drone-works/Shimonso-IoT-Type-R/Shimonso-IoT-Type-R.pdf

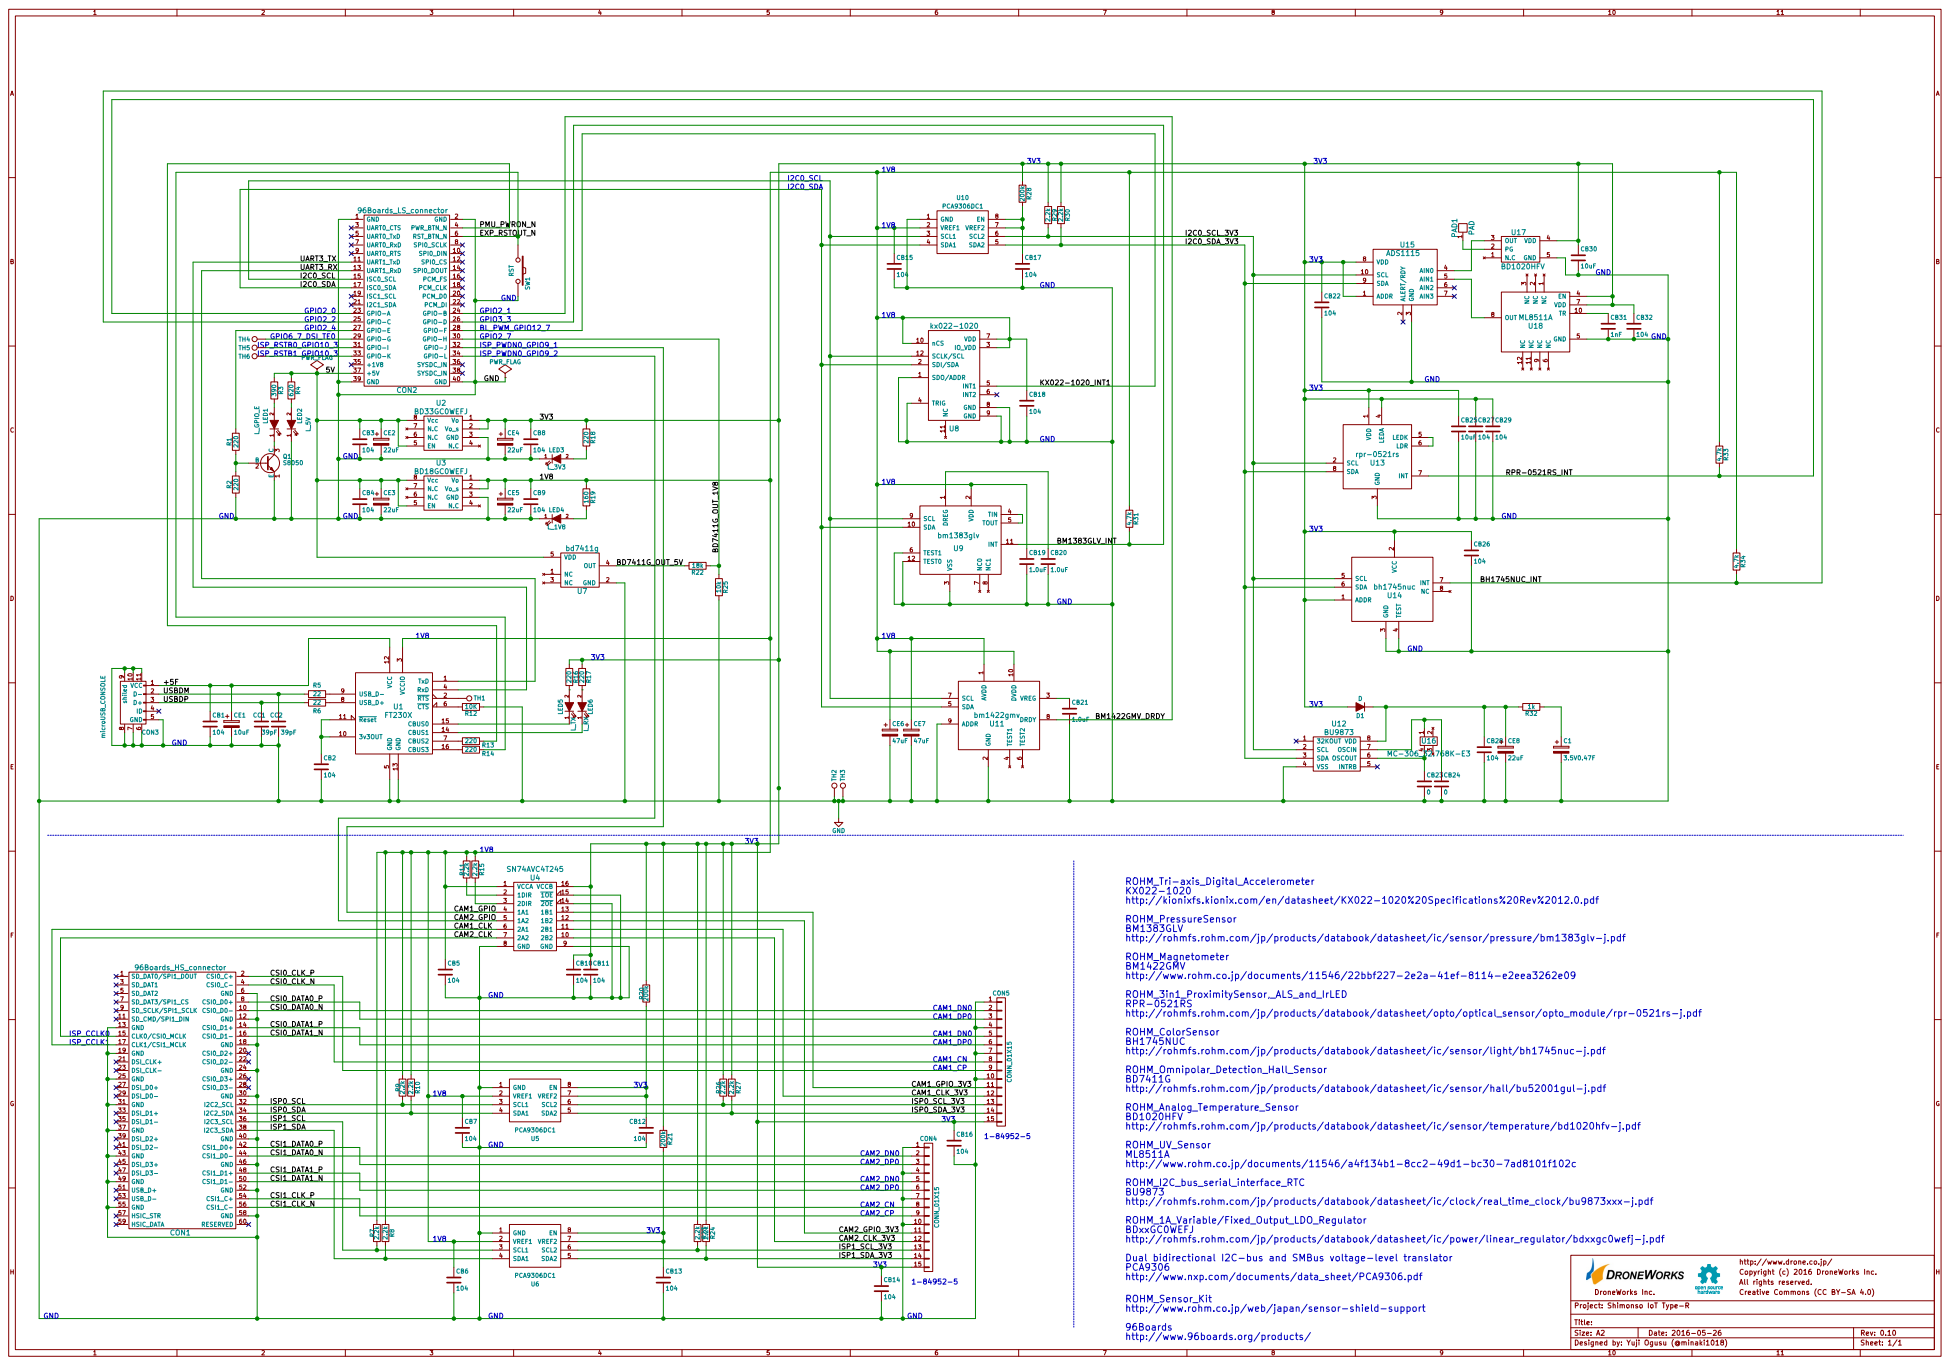
[picture p1: page 1]

I2C0_SCL
I2C0_SDA

LEDK LDR

GND

6 SCL 7 DRDY 8 ADDR 9 DVDD 10 U11

ROHM_Tri-axis_Digital_Accelerometer
http://kionixfs.kionix.com/en/datasheet/KX022-1020%20Specifications%20Rev%2012.0.pdf
ROHM_PressureSensor
BM1383GLV
http://rohmfs.rohm.com/jp/products/databook/datasheet/ic/sensor/pressure/bm1383glv-j.pdf
ROHM_Magnetometer
BM1422GMV
http://www.rohm.co.jp/documents/11546/22bbf227-2e2a-41ef-8114-e2eea3262e09
ROHM_3in1_ProximitySensor,_ALS_and_IrLED
RPR-0521RS
http://rohmfs.rohm.com/jp/products/databook/datasheet/opto/optical_sensor/opto_module/rpr-0521rs-j.pdf
ROHM_ColorSensor
BH1745NUC
http://rohmfs.rohm.com/jp/products/databook/datasheet/ic/sensor/light/bh1745nuc-j.pdf
ROHM_Omnipolar_Detection_Hall_Sensor
http://rohmfs.rohm.com/jp/products/databook/datasheet/ic/sensor/hall/bu52001gul-j.pdf
ROHM_Analog_Temperature_Sensor

CSI0_DATA1_P | CAM1_DP0 | 3

CAM1_DN0 | 4

CAM1_DP0 | 6
CAM1_CN | 7

1V8 | CAM1_GPIO_3V3 | 10

CAM1_CP | 9

ISP0_SCL_3V3 | 13

ISP0_SDA | ISP0_SDA_3V3 | 14
ISP1_SCL
ISP1_SDA
CSI1_CLK_P | CAM2_DP0 | 15CON4 CONN_01X15 CB14 6

104 104 CB6 | CB12 | CAM2_DN0 | 4

BD1020HFV
http://rohmfs.rohm.com/jp/products/databook/datasheet/ic/sensor/temperature/bd1020hfv-j.pdf
ROHM_UV_Sensor
http://www.rohm.co.jp/documents/11546/a4f134b1-8cc2-49d1-bc30-7ad8101f102c
ROHM_I2C_bus_serial_interface_RTC
http://rohmfs.rohm.com/jp/products/databook/datasheet/ic/clock/real_time_clock/bu9873xxx-j.pdf
ROHM_1A_Variable/Fixed_Output_LDO_Regulator
BDxxGC0WEFJ
http://rohmfs.rohm.com/jp/products/databook/datasheet/ic/power/linear_regulator/bdxxgc0wefj-j.pdf
Dual bidirectional I2C-bus and SMBus voltage-level translator
PCA9306

http://www.nxp.com/documents/data_sheet/PCA9306.pdf 1-84952-5

CSI1_DATA1_P | | | CAM2_DP0 | 3

CAM2_CN | 7

CAM2_CP | 9

1V8 | CAM2_GPIO_3V3 | 10

All rights reserved.
Creative Commons (CC BY-SA 4.0)

ROHM_Sensor_Kit
http://www.rohm.co.jp/web/japan/sensor-shield-support
96Boards
http://www.96boards.org/products/

Project: Shimonso IoT Type-R

Designed by: Yuji Ogusu (@minaki1018)
