drone-works/Shimonso-IoT-Type-R/Shimonso-IoT-Type-R.kicad_pcb

## KiCad design Shimonso-IoT-Type-R.kicad_pcb (2016-08-15)

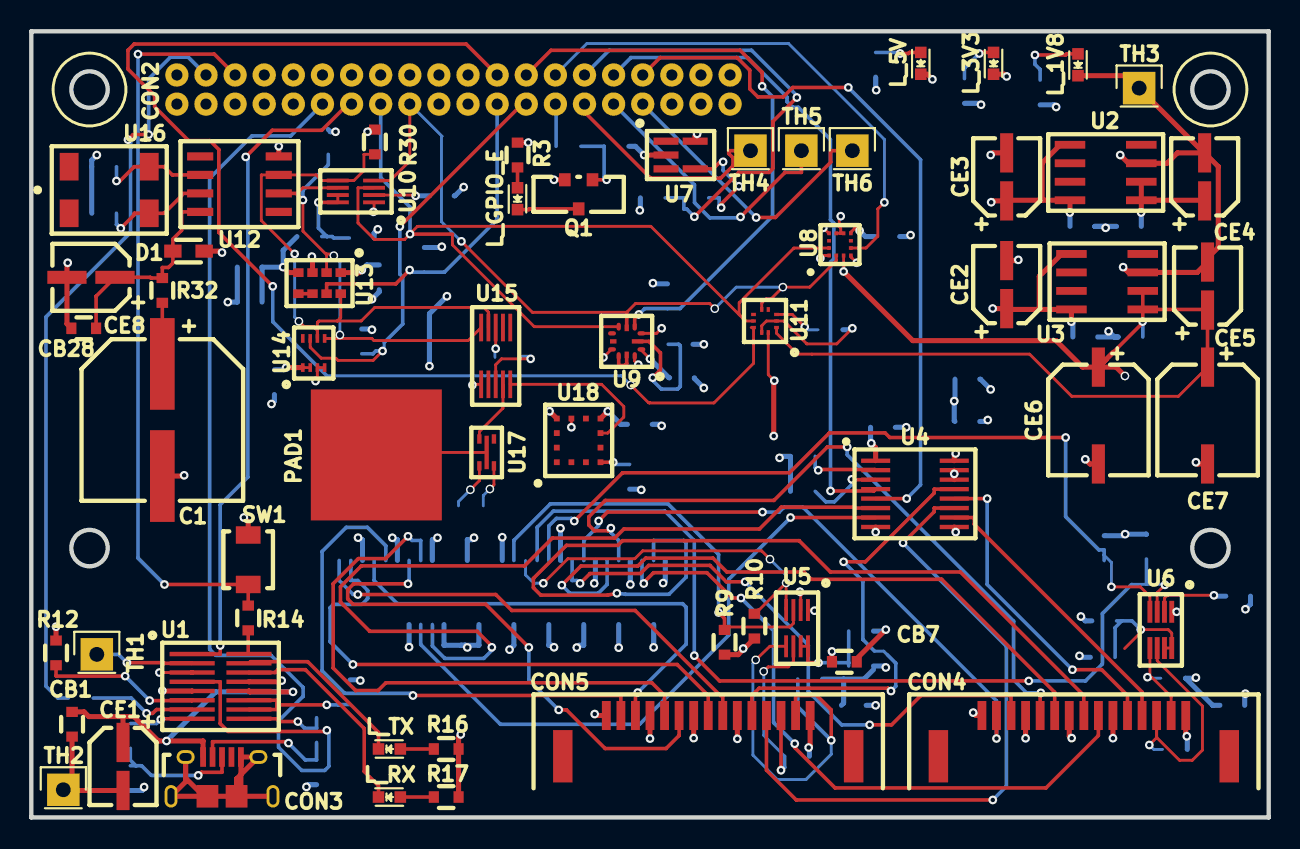
[picture p2: board Shimonso-IoT-Type-R.kicad_pcb from above]

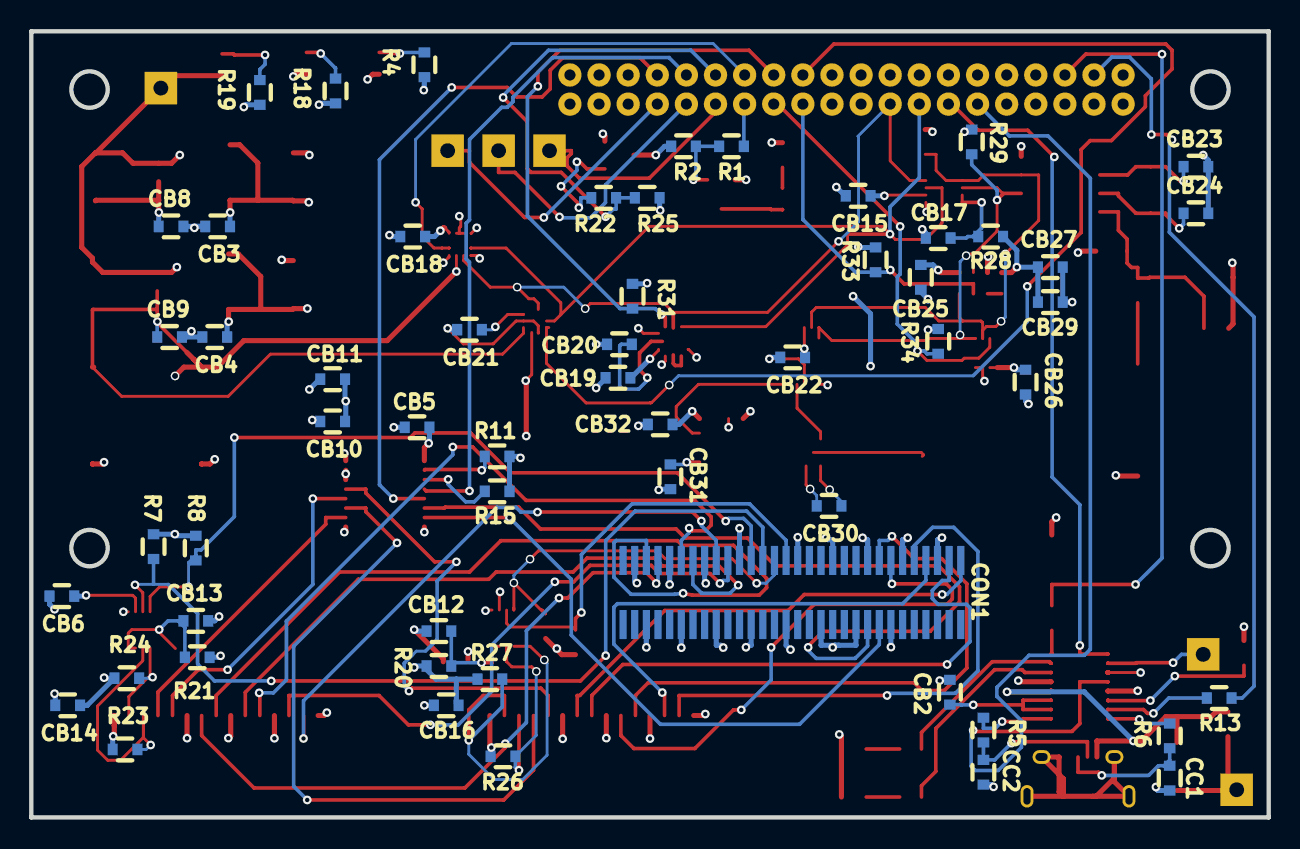
[picture p3: board Shimonso-IoT-Type-R.kicad_pcb from below]

Board: 4 copper layers, 85.0 x 54.0 mm, 116 parts (57 on the bottom side), 88 nets.

Parts:
C1: 3.5V0.47F; FCS0V474ZFTBR24
CB1, CB2, CB3, CB4, CB5, CB6, CB7, CB8, CB9, CB10, CB11, CB12, CB13, CB14, CB15, CB16, CB17, CB18, CB22, CB26, CB27, CB28, CB29, CB32: 104; GRM18
CB19, CB20, CB21: 1.0uF; GRM18
CB23, CB24: 0; GRM18
CB25, CB30: 10uF; GRM18
CB31: 1nF; GRM18
CC1, CC2: 39pF; GRM18
CE1: 10uF; OS-CON-A5
CE2, CE3, CE4, CE5, CE8: 22uF; OS-CON-A5
CE6, CE7: 47uF; OS-CON-C6
CON1: 96Boards_HS_connector; 61083-063402LF
CON2: 96Boards_LS_connector; conn2X20_2mm
CON3: microUSB_CONSOLE; 10118194-0001LF
CON4, CON5: CONN_01X15; 1-84952-5
D1: D; 1SS355
LED1: L_GPIO_E; LED_1608mm
LED2: L_5V; LED_1608mm
LED3: L_3V3; LED_1608mm
LED4: L_1V8; LED_1608mm
LED5: L_TX; LED_1608mm
LED6: L_RX; LED_1608mm
PAD1: PAD
Q1: S8050; MMSS8050
R1, R2, R13, R14, R16, R17, R18: 220; MCR03
R3: 390; MCR03
R4: 620; MCR03
R5, R6: 22; MCR03
R7, R8, R9, R10, R11, R15, R23, R24, R26, R27, R29, R30: 2.2k; MCR03
R12: 10K; MCR03
R19: 160; MCR03
R20, R21, R28: 200k; MCR03
R22: 18k; MCR03
R25: 10k; MCR03
R31, R33, R34: 4.7k; MCR03
R32: 1k; MCR03
SW1: RST; B3U-1000P
TH1, TH2, TH3, TH4, TH5, TH6: TH
U1: FT230X; FT230XS
U2: BD33GC0WEFJ; BDxxGC0WEFJ
U3: BD18GC0WEFJ; BDxxGC0WEFJ
U4: SN74AVC4T245; SN74AVC4T245PWT
U5, U6, U10: PCA9306DC1
U7: bd7411g; BD7411G
U8: kx022-1020; KX022-1020
U9: bm1383glv; BM1383GLV
U11: bm1422gmv; BM1422GMV
U12: BU9873; BU9873F-GTE2
U13: rpr-0521rs; RPR-0521RS
U14: bh1745nuc; BH1745NUC
U15: ADS1115
U16: MC-306_32.768K-E3; MC-306
U17: BD1020HFV; BD1020HFV_test
U18: ML8511A

Connections:
/1V8: CB5.1, CB6.1, CB7.1, CB9.1, CB15.1, CB18.1, CB19.1, CE5.1, CE6.1, CE7.1, R7.1, R8.1, R9.1, R10.1, R11.1, R15.1, R19.1, R31.1, R33.1, R34.1, U1.3, U3.1, U3.2, U4.1, U5.2, U6.2, U8.3, U8.7, U8.10, U9.2, U10.2, U11.1, U11.10
/3V3: CB8.1, CB10.1, CB11.1, CB14.1, CB16.1, CB22.1, CB25.1, CB26.1, CB27.1, CB29.1, CB30.1, CB32.1, CE4.1, CON4.15, CON5.15, D1.2, R16.1, R17.1, R18.1, R20.1, R21.1, R23.1, R24.1, R26.1, R27.1, R28.1, R29.1, R30.1, U2.1, U2.2, U4.16, U13.1, U13.4, U14.1, U14.2, U15.1, U15.8, U17.4, U18.4, U18.7
/5V: CB3.1, CB4.1, CE2.1, CE3.1, CON2.37, R3.1, R4.1, U2.5, U2.8, U3.5, U3.8, U7.5
/+5F: CB1.1, CE1.1, CON3.1, U1.12
/BD7411G_OUT_1V8: CON2.30, R22.1, R25.1
/BD7411G_OUT_5V: R22.2, U7.4
/BH1745NUC_INT: CON2.25, R34.2, U14.7
/BM1383GLV_INT: CON2.26, R31.2, U9.11
/BM1422GMV_DRDY: CON2.24, U11.8
/CAM1_CLK: CON1.17, U4.6
/CAM1_CLK_3V3: CON5.12, U4.11
/CAM1_GPIO: CON2.32, U4.4
/CAM1_GPIO_3V3: CON5.11, U4.13
/CAM2_CLK: CON1.15, U4.7
/CAM2_CLK_3V3: CON4.12, U4.10
/CAM2_GPIO: CON2.34, U4.5
/CAM2_GPIO_3V3: CON4.11, U4.12
/CSI0_CLK_N: CON1.4, CON5.8
/CSI0_CLK_P: CON1.2, CON5.9
/CSI0_DATA0_N: CON1.10, CON5.2
/CSI0_DATA0_P: CON1.8, CON5.3
/CSI0_DATA1_N: CON1.16, CON5.5
/CSI0_DATA1_P: CON1.14, CON5.6
/CSI1_CLK_N: CON1.56, CON4.8
/CSI1_CLK_P: CON1.54, CON4.9
/CSI1_DATA0_N: CON1.44, CON4.2
/CSI1_DATA0_P: CON1.42, CON4.3
/CSI1_DATA1_N: CON1.50, CON4.5
/CSI1_DATA1_P: CON1.48, CON4.6
/EXP_RSTOUT_N: CON2.6, R14.1, SW1.1
/I2C0_SCL: CON2.15, U8.12, U9.9, U10.3, U11.7
/I2C0_SCL_3V3: R29.2, U10.6, U12.2, U13.2, U14.5, U15.10
/I2C0_SDA: CON2.17, U8.2, U9.10, U10.4, U11.5
/I2C0_SDA_3V3: R30.2, U10.5, U12.3, U13.8, U14.6, U15.9
/ISP0_SCL: CON1.32, R9.2, U5.3
/ISP0_SCL_3V3: CON5.13, R26.2, U5.6
/ISP0_SDA: CON1.34, R10.2, U5.4
/ISP0_SDA_3V3: CON5.14, R27.2, U5.5
/ISP1_SCL: CON1.36, R7.2, U6.3
/ISP1_SCL_3V3: CON4.13, R23.2, U6.6
/ISP1_SDA: CON1.38, R8.2, U6.4
/ISP1_SDA_3V3: CON4.14, R24.2, U6.5
/KX022-1020_INT1: CON2.28, U8.5
/PMU_PWRON_N: CON2.4, R13.1
/RPR-0521RS_INT: CON2.23, R33.2, U13.7
/UART3_RX: CON2.13, U1.1
/UART3_TX: CON2.11, U1.4
/USBDM: CC2.1, CON3.2, R5.2
/USBDP: CC1.1, CON3.3, R6.2
GND: C1.2, CB1.2, CB2.2, CB3.2, CB4.2, CB5.2, CB6.2, CB7.2, CB8.2, CB9.2, CB10.2, CB11.2, CB12.2, CB13.2, CB14.2, CB15.2, CB16.2, CB17.2, CB18.2, CB19.2, CB20.2, CB21.2, CB22.2, CB23.2, CB24.2, CB25.2, CB26.2, CB27.2, CB28.2, CB29.2, CB30.2, CB31.2, CB32.2, CC1.2, CC2.2, CE1.2, CE2.2, CE3.2, CE4.2, CE5.2, CE6.2, CE7.2, CE8.2, CON1.6, CON1.12, CON1.13, CON1.18, CON1.19, CON1.24, CON1.25, CON1.30, CON1.31, CON1.37, CON1.40, CON1.43, CON1.46, CON1.49, CON1.52, CON1.55, CON1.58, CON2.1, CON2.2, CON2.39, CON2.40, CON3.5, CON3.6, CON3.7, CON3.8, CON3.9, CON3.10, CON3.11, CON4.1, CON4.4, CON4.7, CON4.10, CON5.1, CON5.4, CON5.7, CON5.10, LED2.1, LED3.1, LED4.1, Q1.1, R2.1, R12.1, R25.2, SW1.2, TH2.1, TH3.1, U1.5, U1.13, U2.3, U3.3, U4.8, U4.9, U4.14, U4.15, U5.1, U6.1, U7.2, U8.1, U8.4, U8.8, U8.9, U9.3, U9.6, U9.12, U10.1, U11.2, U11.9, U12.4, U13.3, U14.3, U14.4, U15.3, U17.5, U18.5
unnamed: C1.1, R32.1
unnamed: CB2.1, U1.10, U1.11
unnamed: CB12.1, R20.2, U5.7, U5.8
unnamed: CB13.1, R21.2, U6.7, U6.8
unnamed: CB17.1, R28.2, U10.7, U10.8
unnamed: CB20.1, U9.1
unnamed: CB21.1, U11.3
unnamed: CB23.1, U12.6, U16.4
unnamed: CB24.1, U12.7, U16.1
unnamed: CB28.1, CE8.1, D1.1, R32.2, U12.8
unnamed: CB31.1, U18.10
unnamed: CON2.27, R1.2
unnamed: CON2.29, TH4.1
unnamed: CON2.31, TH5.1
unnamed: CON2.33, TH6.1
unnamed: LED1.1, Q1.3
unnamed: LED1.2, R3.2
unnamed: LED2.2, R4.2
unnamed: LED3.2, R18.2
unnamed: LED4.2, R19.2
unnamed: LED5.1, U1.15
unnamed: LED5.2, R16.2
unnamed: LED6.1, U1.14
unnamed: LED6.2, R17.2
unnamed: PAD1.1, U17.2
unnamed: Q1.2, R1.1, R2.2
unnamed: R5.1, U1.9
unnamed: R6.1, U1.8
unnamed: R11.2, U4.2
unnamed: R12.2, U1.6
unnamed: R13.2, U1.7
unnamed: R14.2, U1.16
unnamed: R15.2, U4.3
unnamed: TH1.1, U1.2
unnamed: U9.4, U9.5
unnamed: U13.5, U13.6
unnamed: U15.4, U17.3
unnamed: U15.5, U18.8
