drone-works/Shimonso-IoT-Type-R/(commit log)

2016-05-22 Add name of camera connectors.
    [Shimonso-IoT-Type-R.sch]
2016-05-22 Change connections of CAM_GPIO.
    [Shimonso-IoT-Type-R.sch]
2016-05-22 Change parts of LS_Connector. Rev 0.03
    [Shimonso-IoT-Type-R.sch]
2016-05-22 Change parts of HS connector Rev 0.04
    [Shimonso-IoT-Type-R.sch]
2016-05-22 Add LEDs and a reset button.
    [Shimonso-IoT-Type-R.sch]
2016-05-22 Add LEDs for LDO Rev 0.06
    [Shimonso-IoT-Type-R.sch]
2016-05-22 Add KX022-1020 foot print
2016-05-23 Add a footprint of BM1745GLV
2016-05-23 Change a footprint BM1383GLV
2016-05-24 Change text
    [Shimonso-IoT-Type-R.sch]
2016-05-24 Add a footprint of BM1422GMV
2016-05-24 Add a footprint of RPR-0521RS
2016-05-24 Add a footprint of BH1745NUC
2016-05-24 Add a footprint of BD7411G
2016-05-26 Add comments Rev 0.08
    [Shimonso-IoT-Type-R.sch]
2016-05-27 Add footprints of BD1020HFV and BDxxGC0WEFJ
2016-05-29 Modified footprints
2016-05-29 Add a footprint of ADS1115
2016-05-30 Add a footprint of BU9873F-GTE2
2016-05-31 Add a footprint of PCA9306DC1
2016-06-08 Add footprints
2016-06-08 Add CSI connector
2016-06-21 Add footprints of transistor, PAD and Diode.
2016-06-21 Initial commit for pcb file
    [Shimonso-IoT-Type-R.kicad_pcb, Shimonso-IoT-Type-R.sch]
2016-06-25 placement modified
    [Shimonso-IoT-Type-R.kicad_pcb]
2016-08-10 Add outputdata directory
    [Shimonso-IoT-Type-R-B.Cu.gbl, Shimonso-IoT-Type-R-B.Mask.gbs, Shimonso-IoT-Type-R-B.SilkS.gbo, Shimonso-IoT-Type-R-Edge.Cuts.gm1, Shimonso-IoT-Type-R-F.Cu.gtl, Shimonso-IoT-Type-R-F.Mask.gts, Shimonso-IoT-Type-R-F.SilkS.gto, Shimonso-IoT-Type-R-drl_map.gbr]
2016-08-10 modified outputdata
    [Shimonso-IoT-Type-R-B.Cu.gbl, Shimonso-IoT-Type-R-B.Mask.gbs, Shimonso-IoT-Type-R-B.SilkS.gbo, Shimonso-IoT-Type-R-Edge.Cuts.gm1, Shimonso-IoT-Type-R-F.Cu.gtl, Shimonso-IoT-Type-R-F.Mask.gts, Shimonso-IoT-Type-R-F.SilkS.gto, Shimonso-IoT-Type-R-drl_map.gbr]
2016-08-10 modified coodinate axis
    [Shimonso-IoT-Type-R-B.Cu.gbl, Shimonso-IoT-Type-R-B.Mask.gbs, Shimonso-IoT-Type-R-B.SilkS.gbo, Shimonso-IoT-Type-R-Edge.Cuts.gm1, Shimonso-IoT-Type-R-F.Cu.gtl, Shimonso-IoT-Type-R-F.Mask.gts, Shimonso-IoT-Type-R-F.SilkS.gto, Shimonso-IoT-Type-R-drl_map.gbr]
2016-08-15 change to autorout pcb
    [Shimonso-IoT-Type-R.kicad_pcb]
