drone-works/Shimonso-IoT-Type-R/(notices)

Notices in the files:
Shimonso-IoT-Type-R.sch:
Copyright (c) 2016 DroneWorks Inc.
